alvaroadpe/tamagonkey/animations png/Banana.png

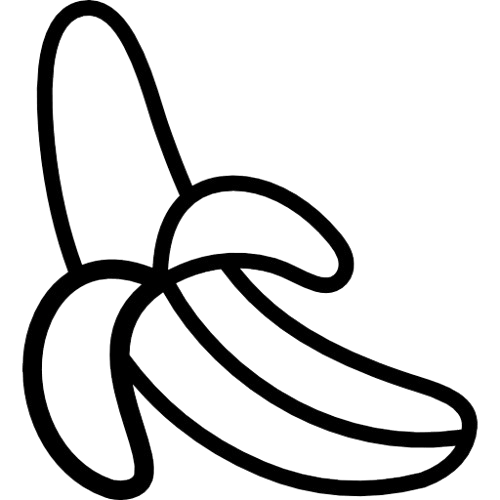
animations png/Banana.png
