alvaroadpe/tamagonkey/Electronic schematics/Electronic Schematics.png

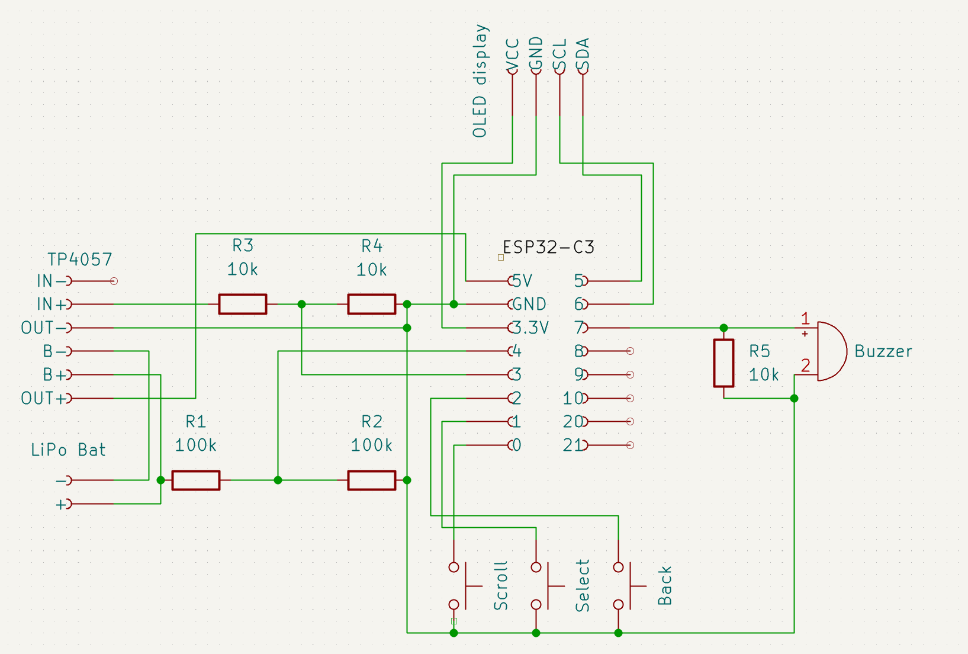
Electronic schematics/Electronic Schematics.png
