alvaroadpe/tamagonkey/box 3D print/tapa.3mf

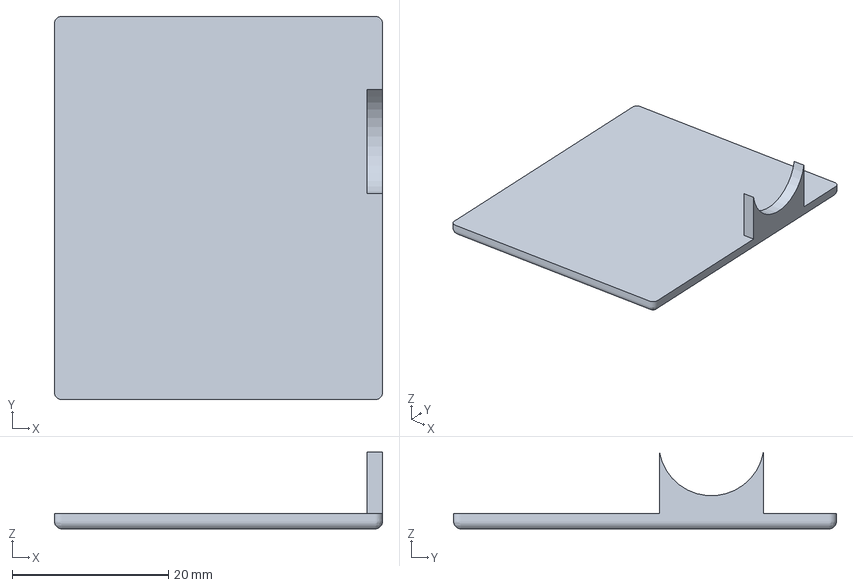
[picture p3: CAD file, 2026-11-03]
box 3D print/tapa.3mf
42.0 x 49.0 x 9.84 mm
