alvaroadpe/tamagonkey/box 3D print/cuerpo.3mf

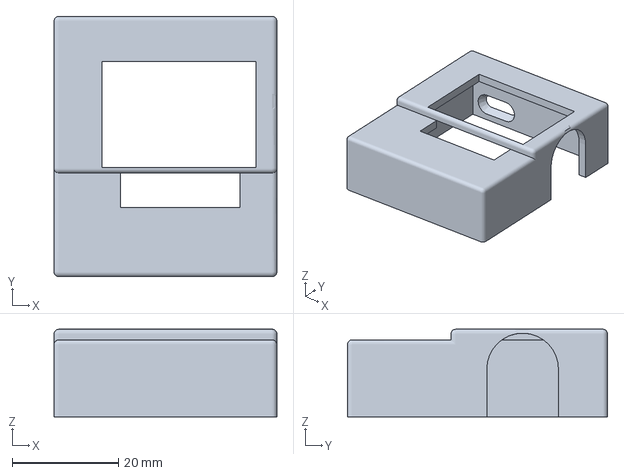
[picture p4: CAD file, 2026-11-03]
box 3D print/cuerpo.3mf
42.0 x 49.0 x 16.5 mm
