alvaroadpe/tamagonkey/Electronic schematics/Kicad schematics.kicad_sch

## KiCad design Electronic schematics/Kicad schematics.kicad_sch (2026-11-03)

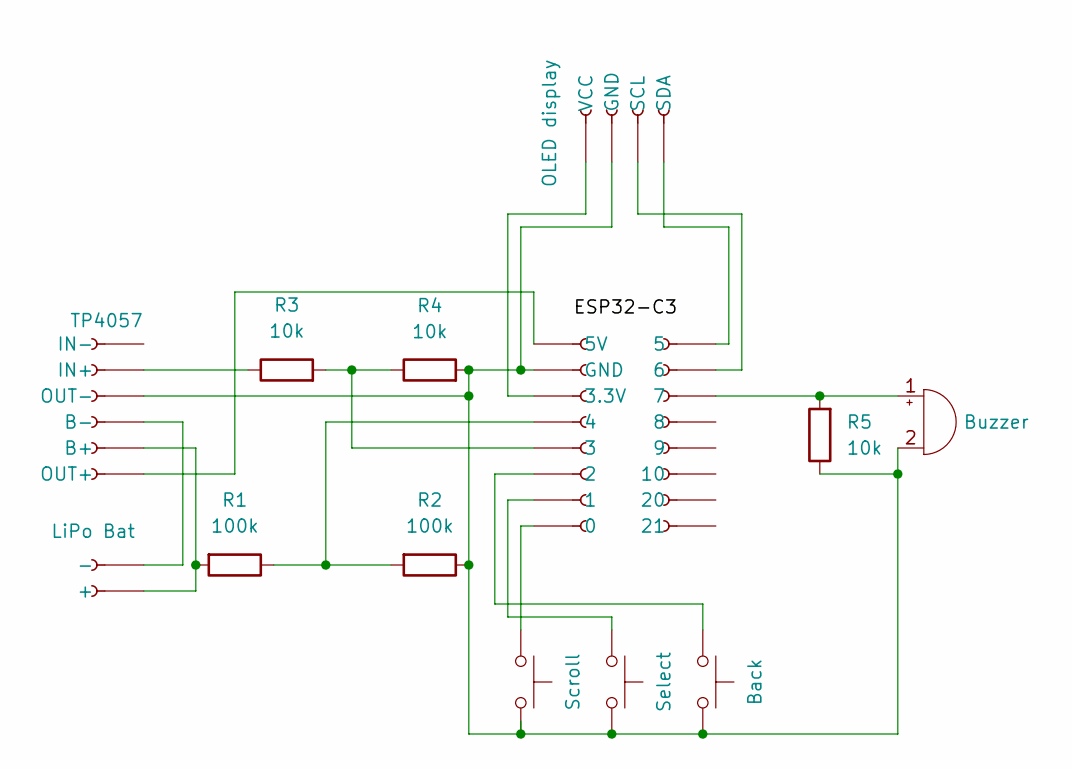
[picture p5: schematic Kicad schematics.kicad_sch]

Parts:
BZ1: Buzzer
J1, J2: (no value)
J3: OLED display
J4: TP4057
J5: LiPo Bat
R1, R2: 100k
R3, R4, R5: 10k
SW1: Scroll
SW2: Select
SW3: Back

Connections:
unnamed: BZ1.1 (+), J1.3 (7), R5.2
unnamed: BZ1.2 (-), J2.2 (GND), J3.2 (GND), J4.3 (OUT-), R2.1, R4.2, R5.1, SW1.2, SW2.2, SW3.2
unnamed: J1.1 (5), J3.4 (SDA)
unnamed: J1.2 (6), J3.3 (SCL)
unnamed: J2.1 (5V), J4.6 (OUT+)
unnamed: J2.3 (3.3V), J3.1 (VCC)
unnamed: J2.4, R1.1, R2.2
unnamed: J2.5 (3), R3.2, R4.1
unnamed: J2.6 (2), SW3.1
unnamed: J2.7 (1), SW2.1
unnamed: J2.8 (0), SW1.1
unnamed: J4.2 (IN+), R3.1
unnamed: J4.4 (B-), J5.1 (-)
unnamed: J4.5 (B+), J5.2 (+), R1.2
