alvaroadpe/tamagonkey/ecofriendly2/images.h

#pragma once
#include <Arduino.h>

// 'happy onkey', 57x32px
// 'happy onkey inverse', 57x32px
const unsigned char epd_bitmap_happy_onkey [] PROGMEM = {
	0x00, 0x00, 0x00, 0x00, 0x00, 0x00, 0x00, 0x00, 0x00, 0x00, 0x00, 0x18, 0x00, 0x00, 0x00, 0x00, 
	0x00, 0x00, 0x00, 0x3c, 0x00, 0x00, 0x00, 0x00, 0x00, 0x00, 0x00, 0x3c, 0x00, 0x00, 0x00, 0x00, 
	0x00, 0x00, 0x00, 0x3c, 0x00, 0x00, 0x00, 0x00, 0x00, 0x00, 0x00, 0x38, 0x00, 0x00, 0x00, 0x00, 
	0x00, 0x00, 0x01, 0xff, 0xe0, 0x00, 0x00, 0x00, 0x00, 0x00, 0x03, 0xff, 0xf0, 0x00, 0x00, 0x00, 
	0x00, 0x00, 0x07, 0xff, 0xf8, 0x00, 0x00, 0x00, 0x00, 0x00, 0x0f, 0xff, 0xfc, 0x00, 0x00, 0x00, 
	0x00, 0x00, 0x1f, 0xff, 0xfc, 0x00, 0x00, 0x00, 0x00, 0x00, 0x1f, 0xff, 0xfc, 0x00, 0x00, 0x00, 
	0x00, 0x00, 0x1f, 0xff, 0xfc, 0x00, 0x00, 0x00, 0x00, 0x00, 0x1f, 0xff, 0xfc, 0x00, 0x00, 0x00, 
	0x00, 0x00, 0x1f, 0xff, 0xfc, 0x00, 0x00, 0x00, 0x00, 0x03, 0xff, 0xff, 0xff, 0xe0, 0x00, 0x00, 
	0x00, 0x0f, 0xfb, 0x3f, 0x07, 0xf0, 0x00, 0x00, 0x00, 0x1c, 0x1b, 0x3f, 0x34, 0x38, 0x00, 0x00, 
	0x00, 0x1c, 0x18, 0x3f, 0x34, 0x18, 0x00, 0x00, 0x00, 0x18, 0x18, 0x3f, 0x04, 0x18, 0x00, 0x00, 
	0x00, 0x18, 0x18, 0x3f, 0x04, 0x18, 0x00, 0x00, 0x00, 0x18, 0x1f, 0xff, 0xfc, 0x18, 0x00, 0x00, 
	0x00, 0x1c, 0x1f, 0xff, 0xfc, 0x38, 0x00, 0x00, 0x00, 0x0f, 0xff, 0xde, 0xff, 0xf0, 0x00, 0x00, 
	0x00, 0x07, 0xff, 0xde, 0xff, 0xe0, 0x00, 0x00, 0x38, 0x00, 0x3f, 0xe1, 0xfc, 0x00, 0x38, 0x00, 
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
  0b00111100,
  0b01000010,
  0b10100101,
  0b10000001,
  0b10100101,
  0b10011001,
  0b01000010,
  0b00111100
};

const unsigned char PROGMEM icon_clock[] = {
  0b00111100,
  0b01000110,
  0b10000101,
  0b10001101,
  0b10000001,
  0b10000001,
  0b01000010,
  0b00111100
};
